lauravmorenoc/Praxis_Laura/Pictures/1.jpg

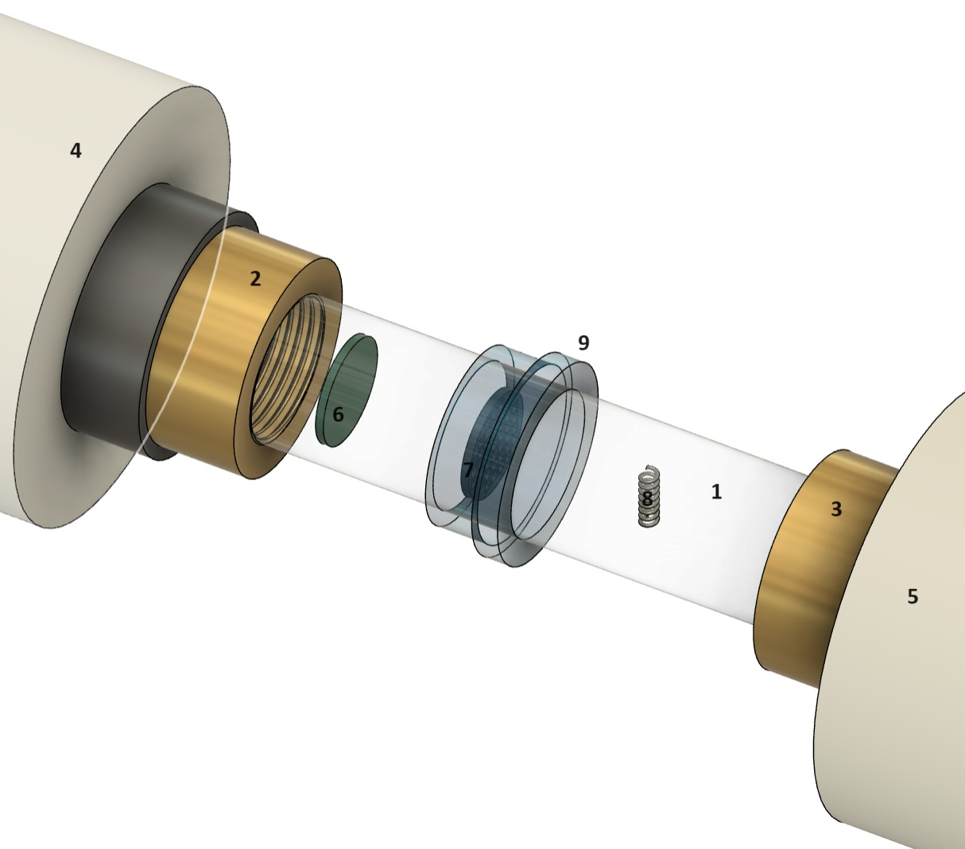
Pictures/1.jpg
