lauravmorenoc/Praxis_Laura/README.md

# Praxis_Laura

### Decided on 19.12.2023:
Die Idee, die die vier Stäbchen hat, können wir versuchen. Aber statt der Löchen in den Ringen kann man was, das die Ringen stützt (wie Schraube), benutzen.
