lauravmorenoc/Praxis_Laura/Pictures/2.jpg

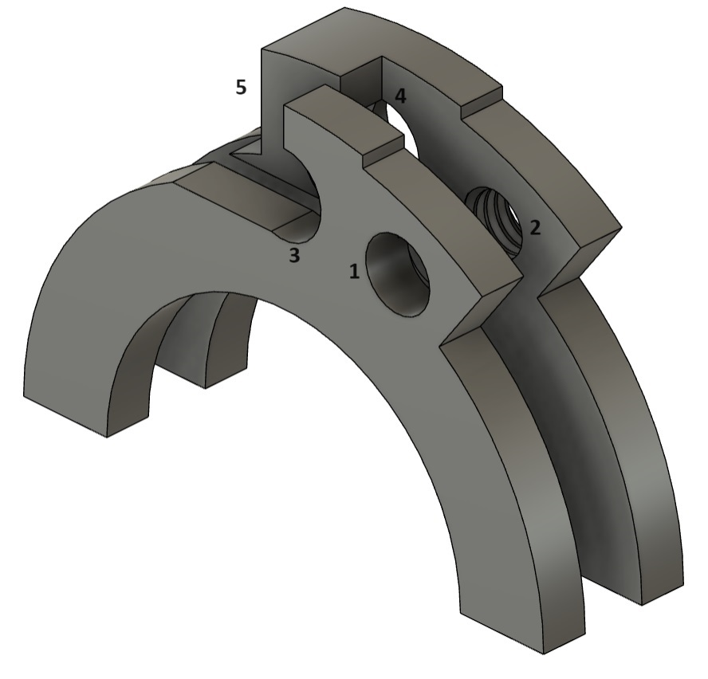
Pictures/2.jpg
