lauravmorenoc/Praxis_Laura/Pictures/2_1.jpg

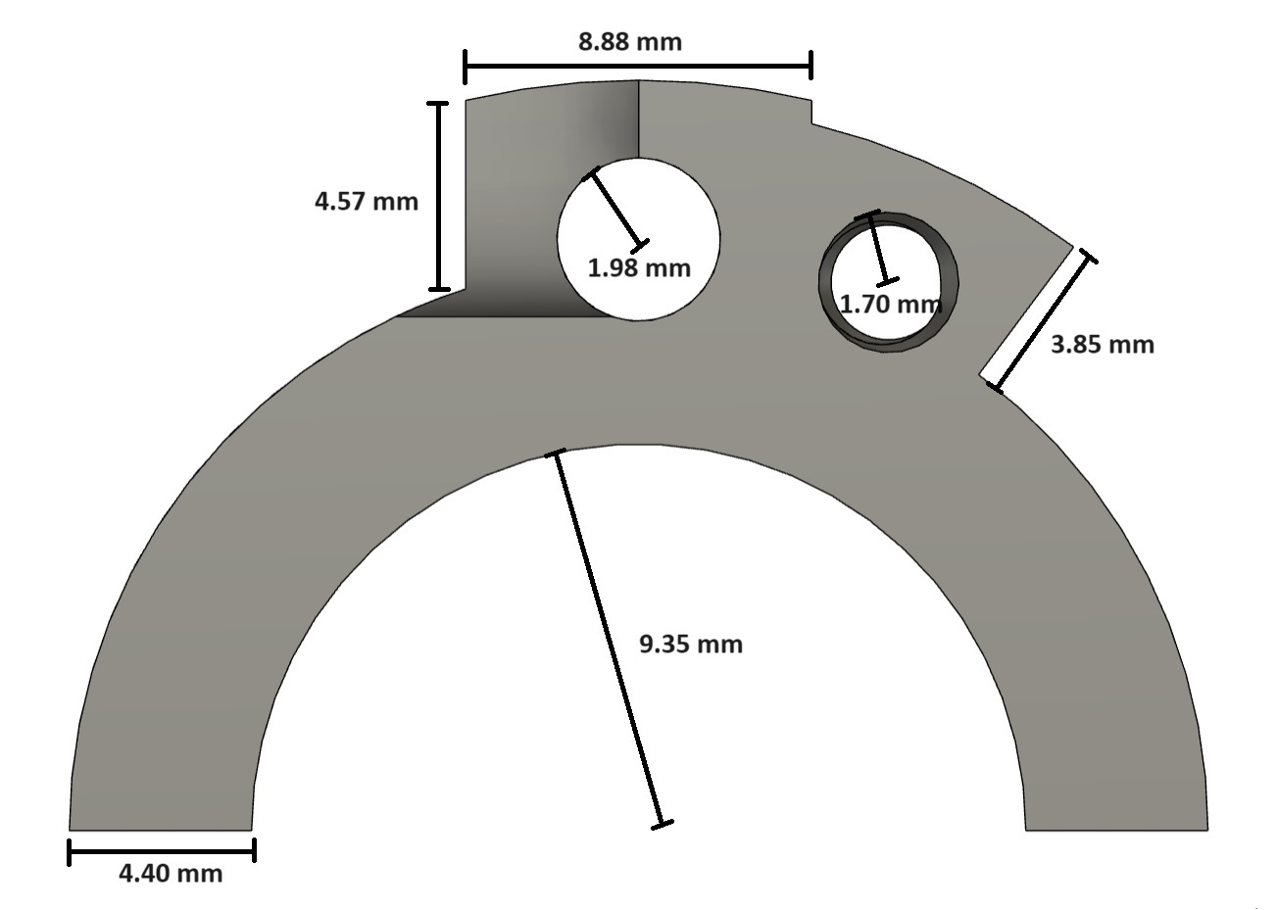
Pictures/2_1.jpg
