lauravmorenoc/Praxis_Laura/Pictures/2_2.jpg

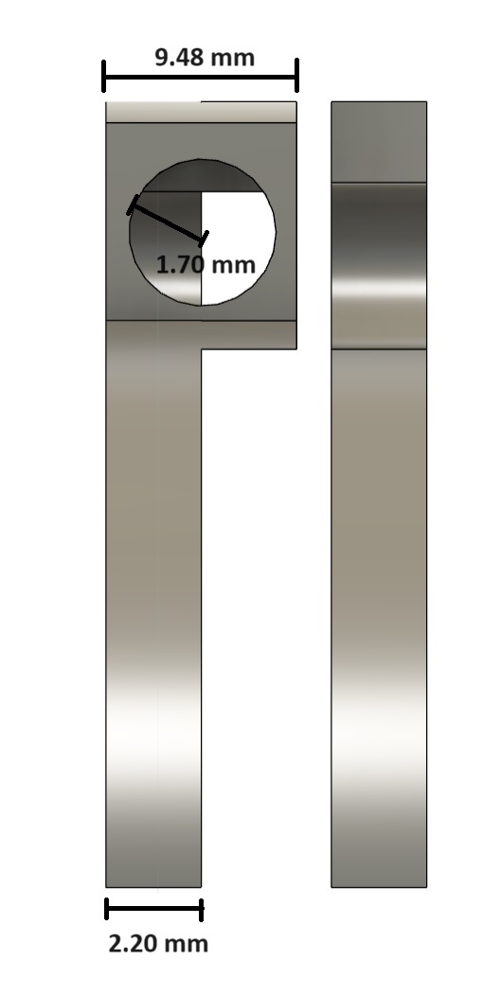
Pictures/2_2.jpg
