lauravmorenoc/Praxis_Laura/Pictures/3.jpg

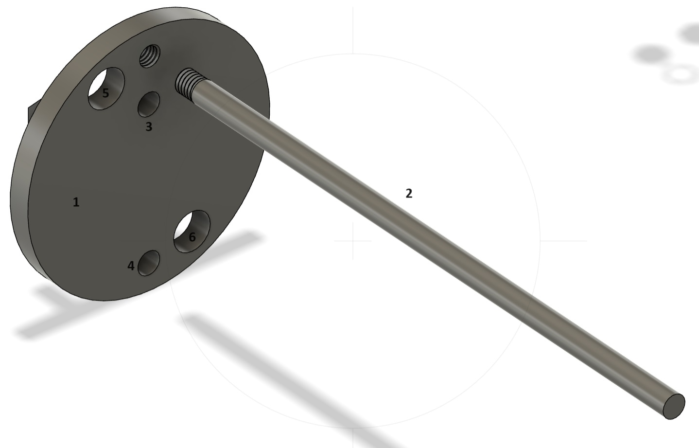
Pictures/3.jpg
