lauravmorenoc/Praxis_Laura/Pictures/3_1.jpg

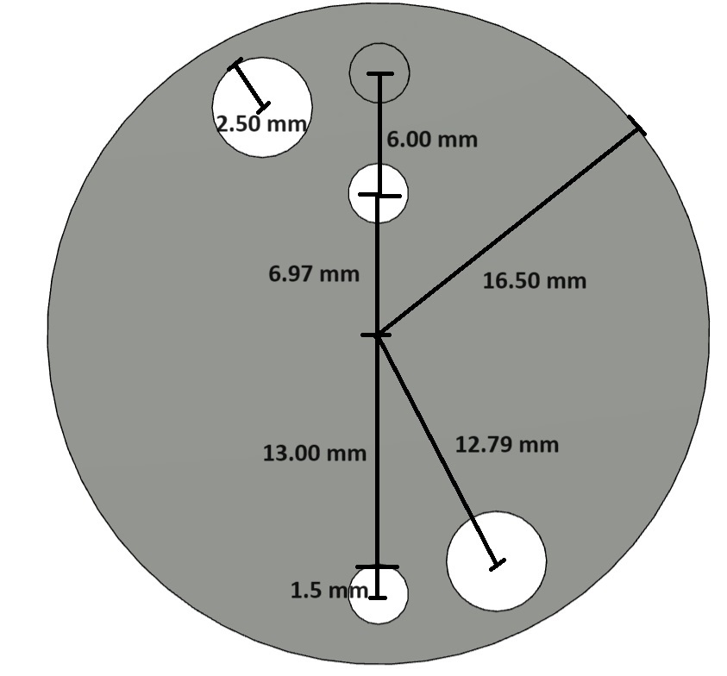
Pictures/3_1.jpg
