lauravmorenoc/Praxis_Laura/Pictures/3_2.jpg

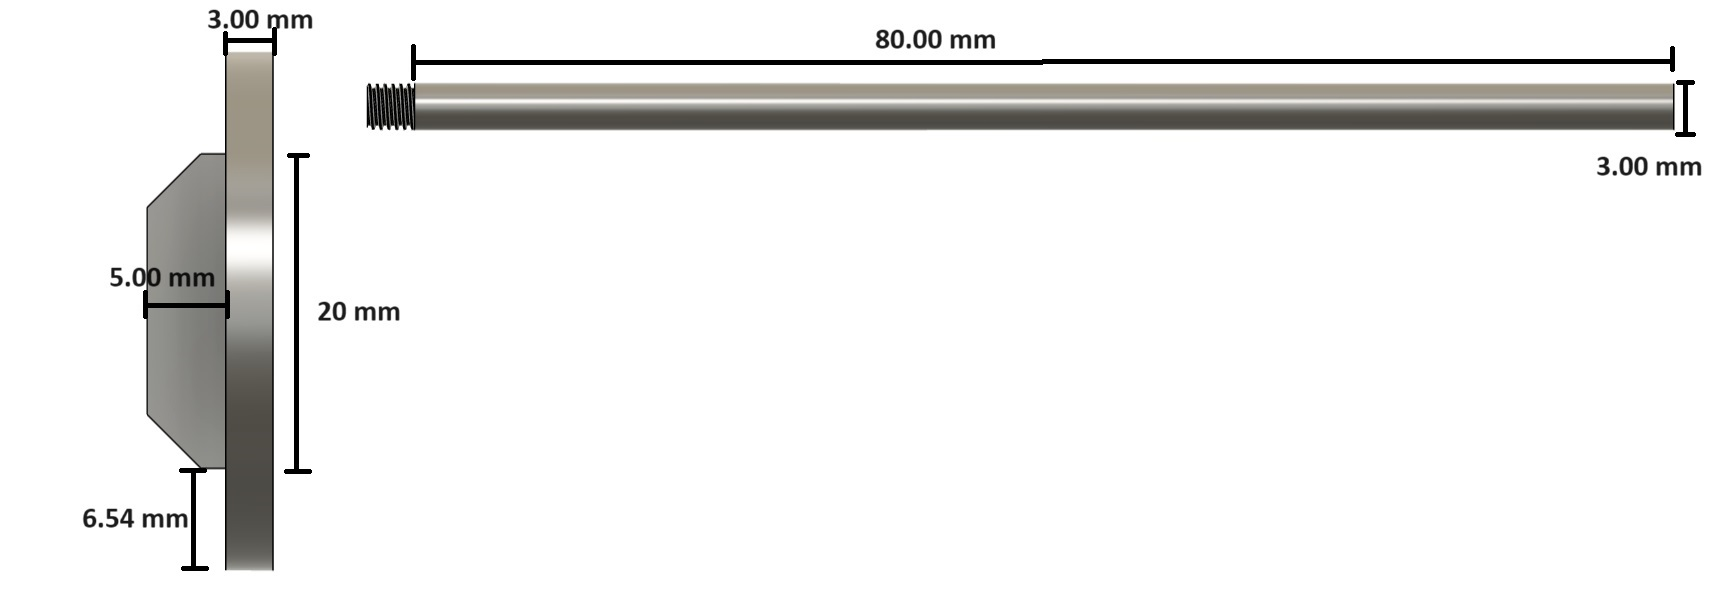
Pictures/3_2.jpg
