lauravmorenoc/Praxis_Laura/Pictures/4.jpg

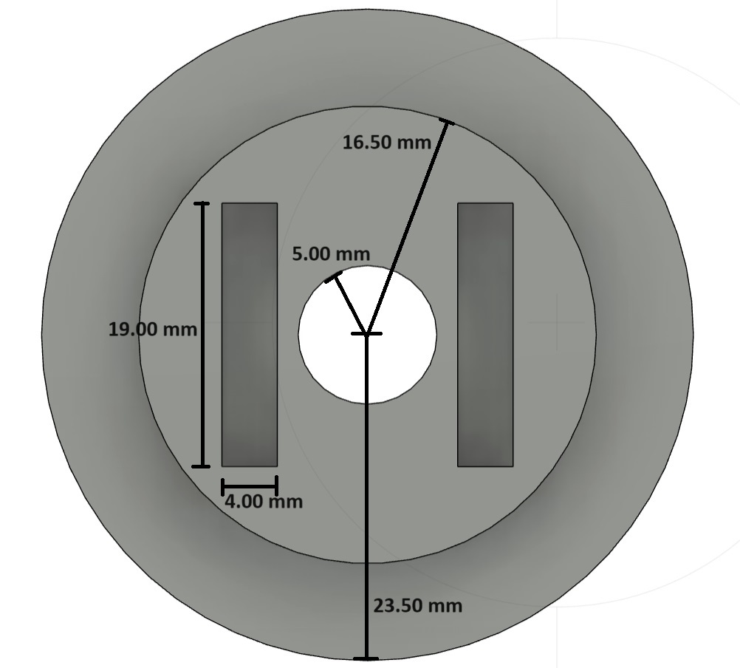
Pictures/4.jpg
