lauravmorenoc/Praxis_Laura/Pictures/4_1.jpg

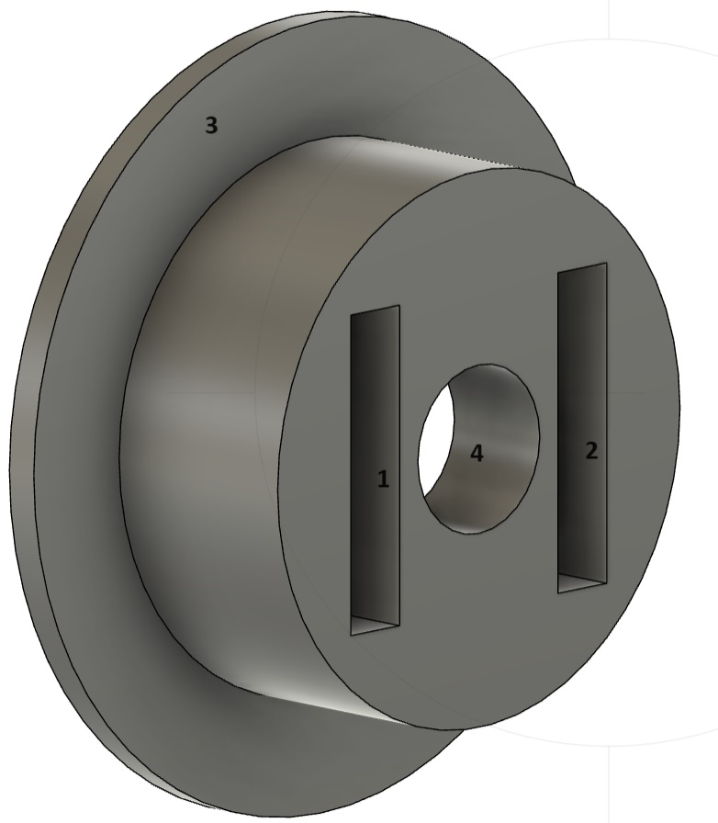
Pictures/4_1.jpg
