lauravmorenoc/Praxis_Laura/Pictures/5.jpg

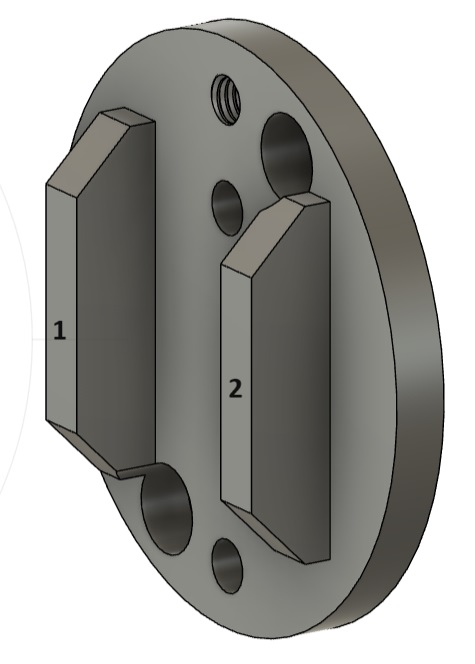
Pictures/5.jpg
