lauravmorenoc/Praxis_Laura/Pictures/6.jpg

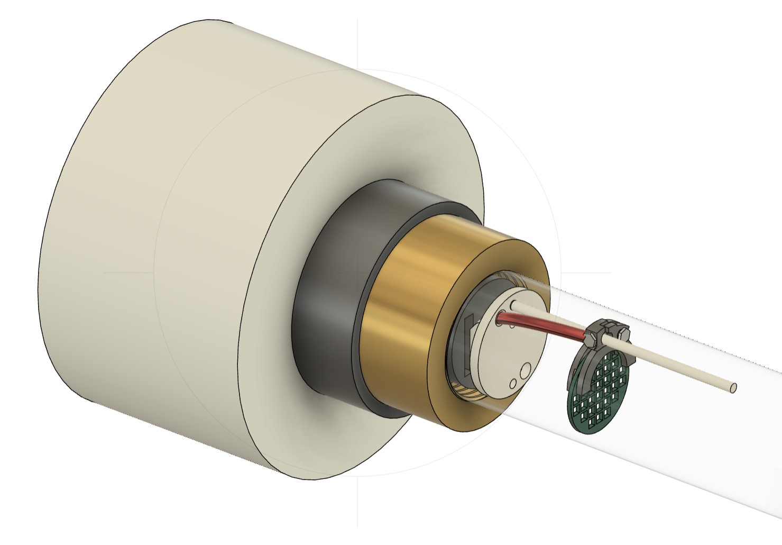
Pictures/6.jpg
