lauravmorenoc/Praxis_Laura/Pictures/Circuit.jpeg

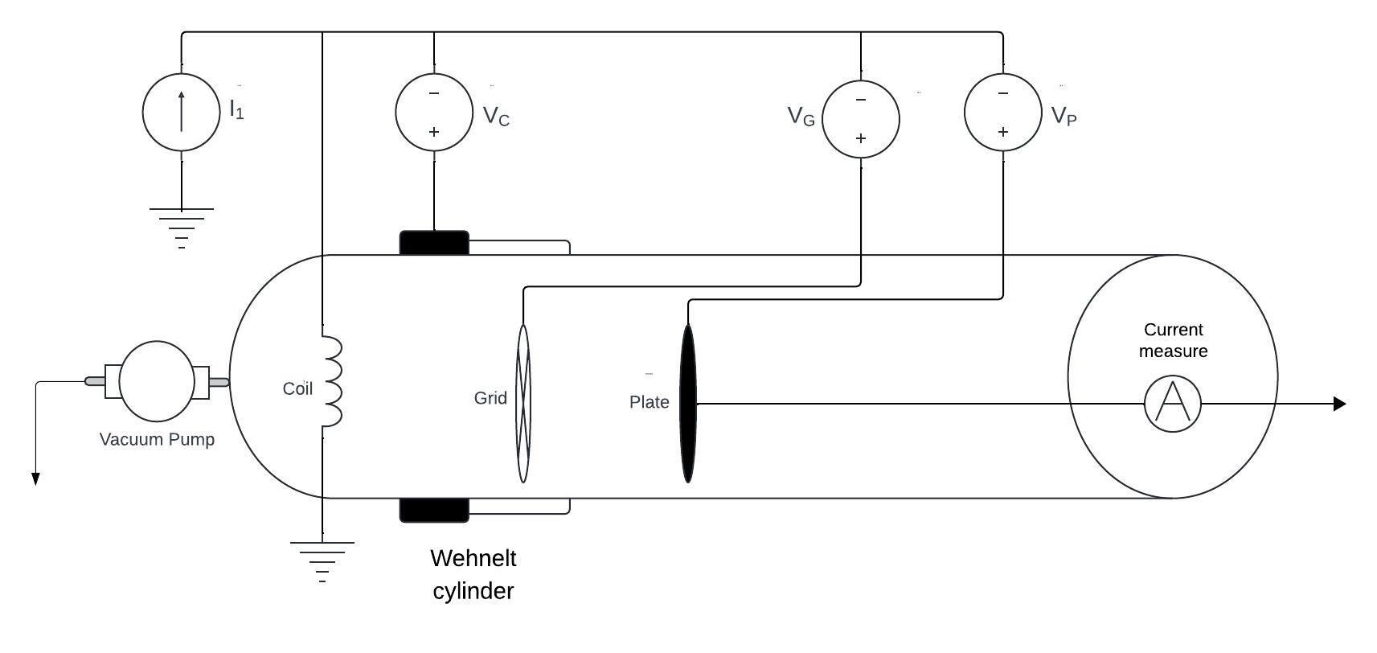
Pictures/Circuit.jpeg
