lauravmorenoc/Praxis_Laura/Pictures/Circuit_upd.jpeg

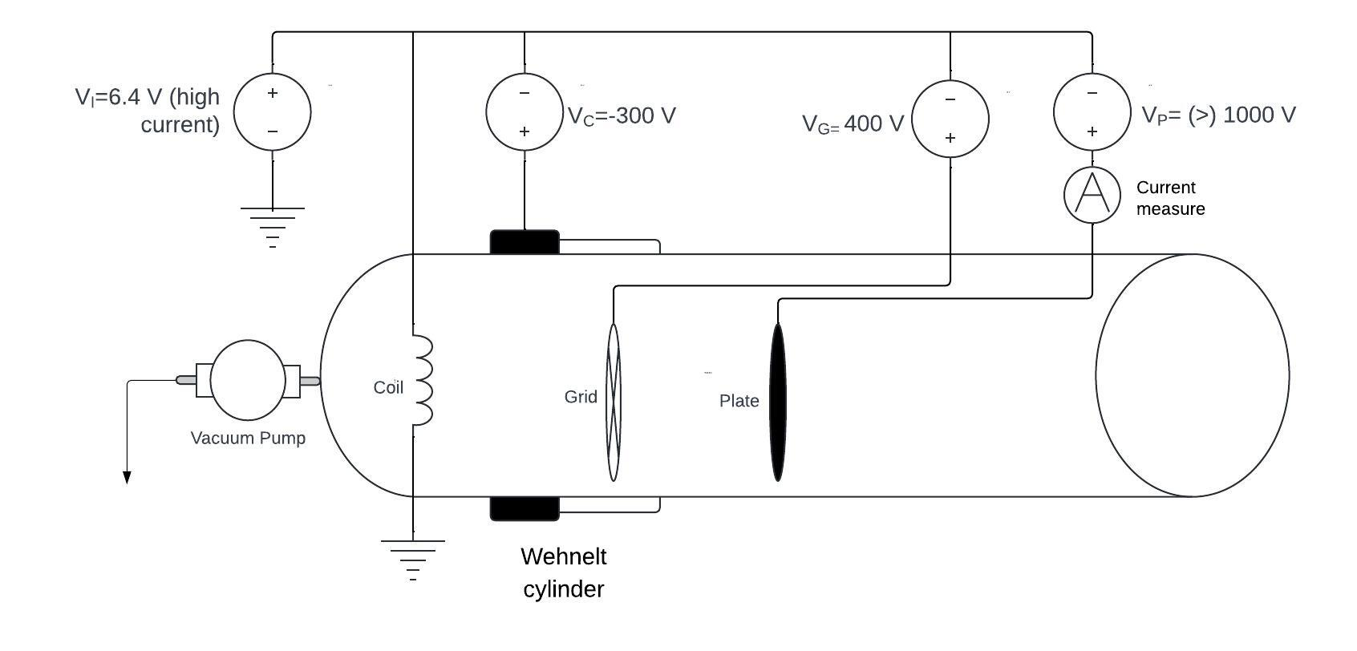
Pictures/Circuit_upd.jpeg
