lauravmorenoc/Praxis_Laura/Pictures/cylinder.jpg

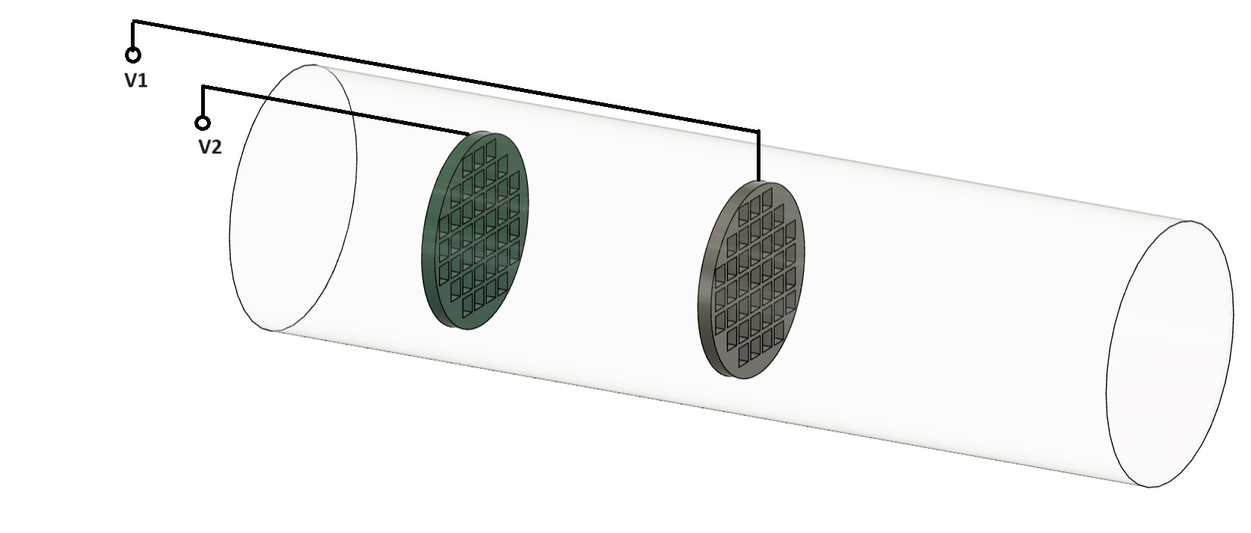
Pictures/cylinder.jpg
