lauravmorenoc/Praxis_Laura/Pictures/op.png

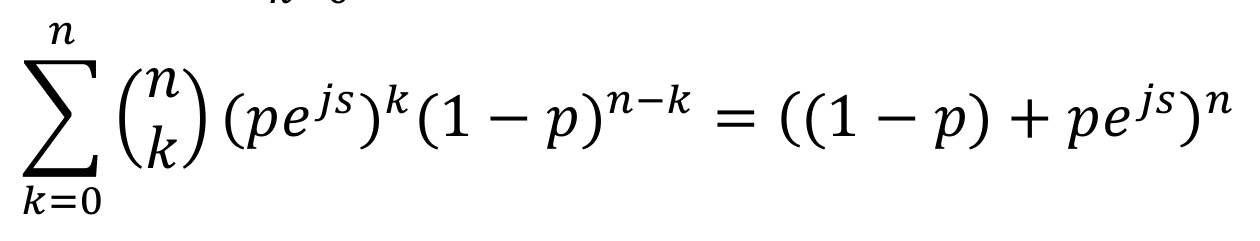
Pictures/op.png
