lauravmorenoc/Praxis_Laura/Pictures/Paschen.png

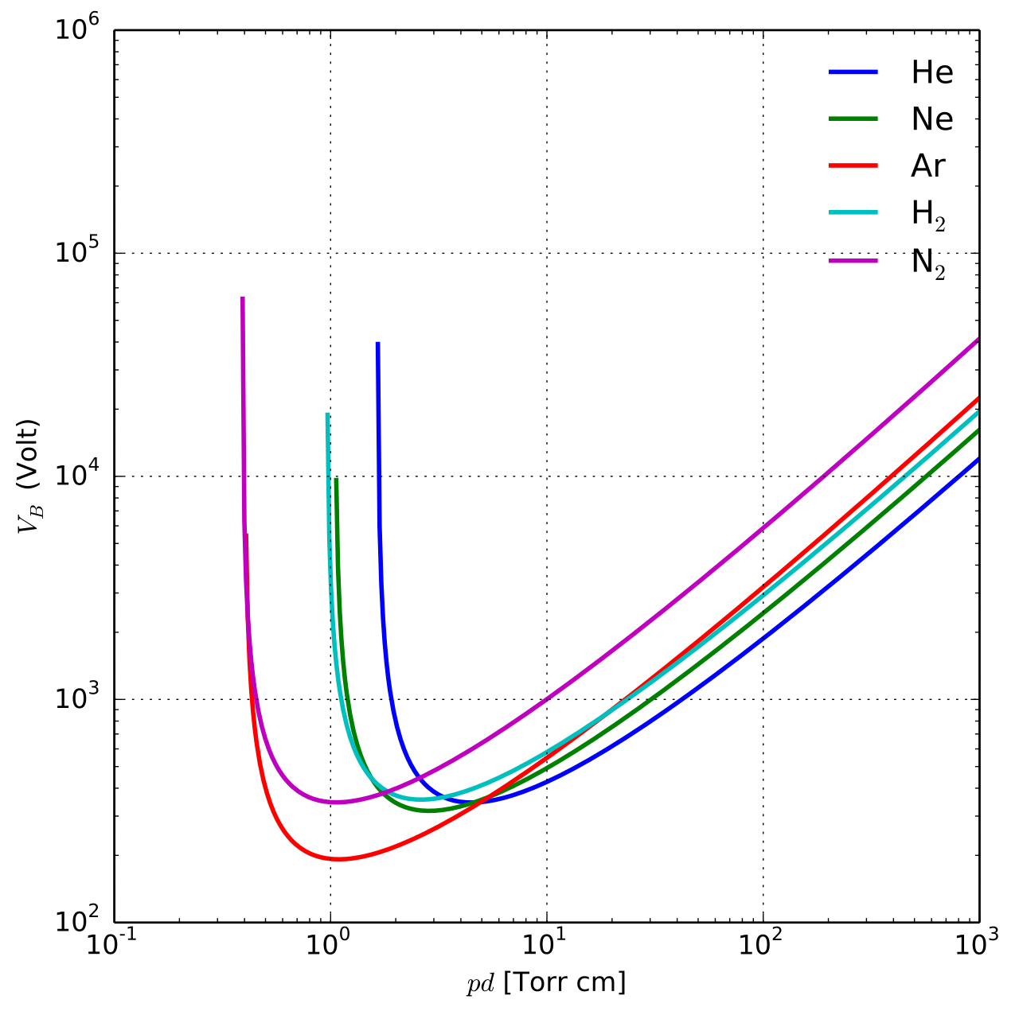
Pictures/Paschen.png
