lauravmorenoc/Praxis_Laura/Pictures/voltages.png

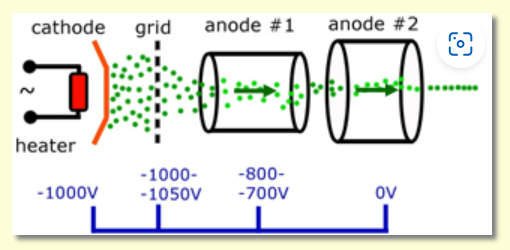
Pictures/voltages.png
