lauravmorenoc/Praxis_Laura/Beispiel.3mf

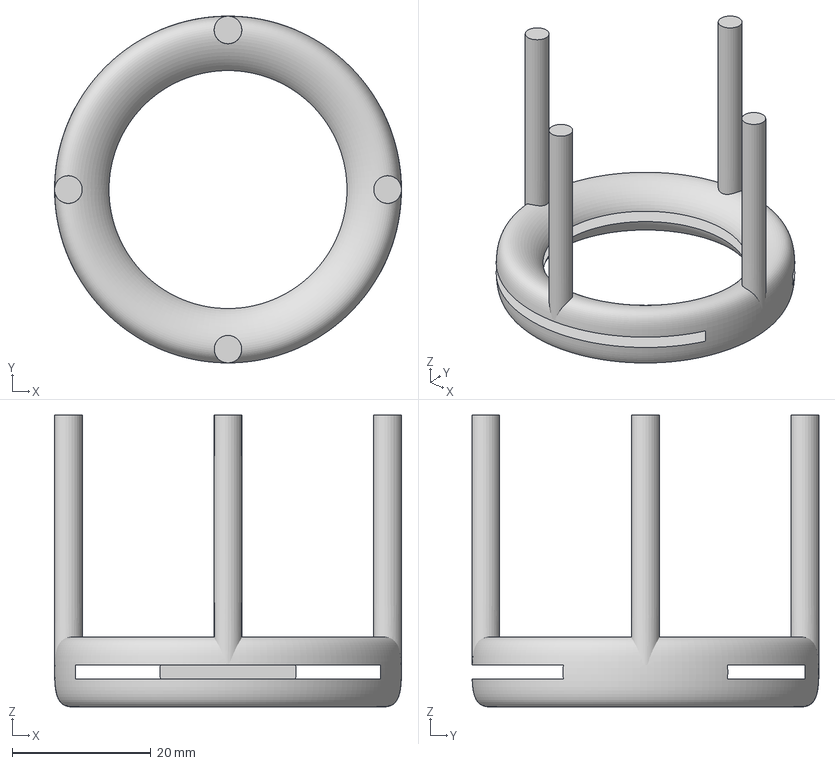
[picture p18: CAD file, 2023-12-19]
Beispiel.3mf
50.0 x 50.0 x 42.0 mm
