lauravmorenoc/Praxis_Laura/Design/Flaeche.dxf

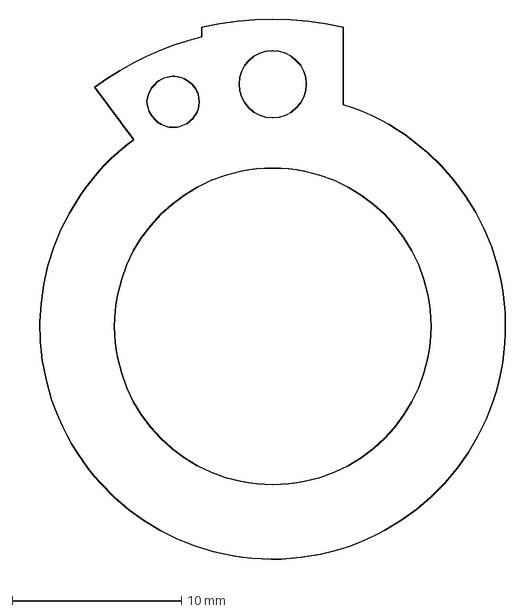
[picture p19: CAD file, 2024-06-17]
Design/Flaeche.dxf
29.3 x 32.9 mm
