lauravmorenoc/Praxis_Laura/Design/Körper13.stl

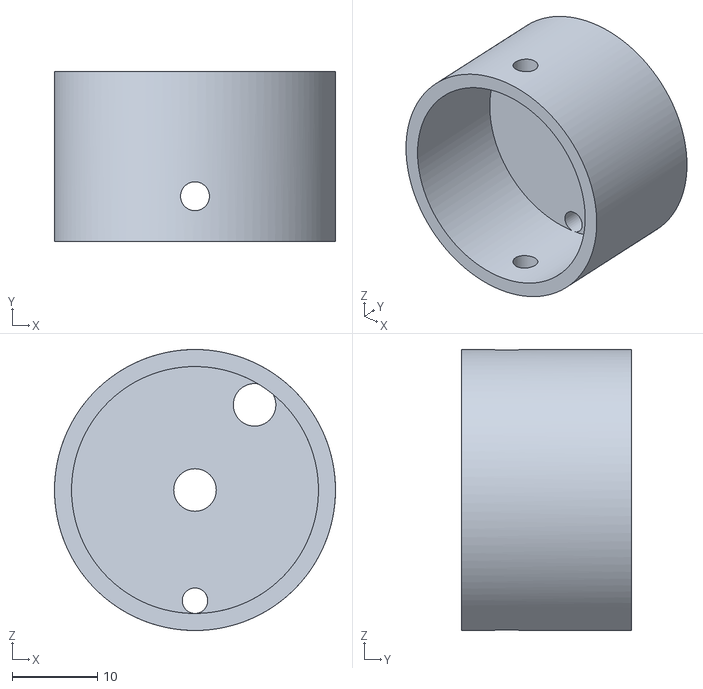
[picture p20: CAD file, 2024-06-17]
Design/Körper13.stl
33.0 x 20.0 x 33.0
