lauravmorenoc/Praxis_Laura/Design/Gewinde_klein.stl

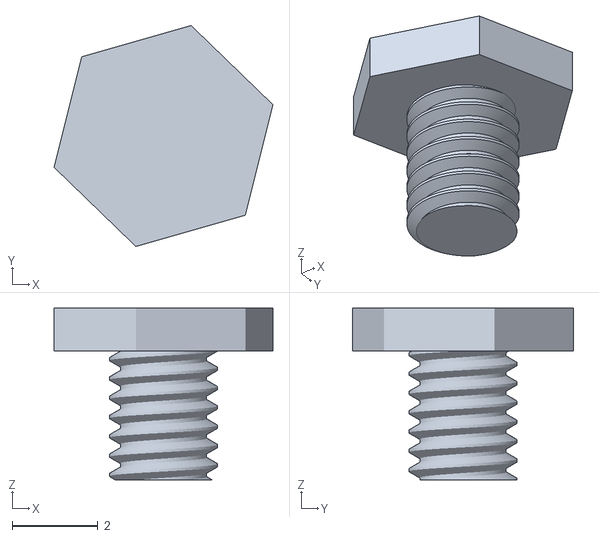
[picture p21: CAD file, 2024-06-17]
Design/Gewinde_klein.stl
5.11 x 5.15 x 4.00
