lauravmorenoc/Praxis_Laura/Design/Körper12.stl

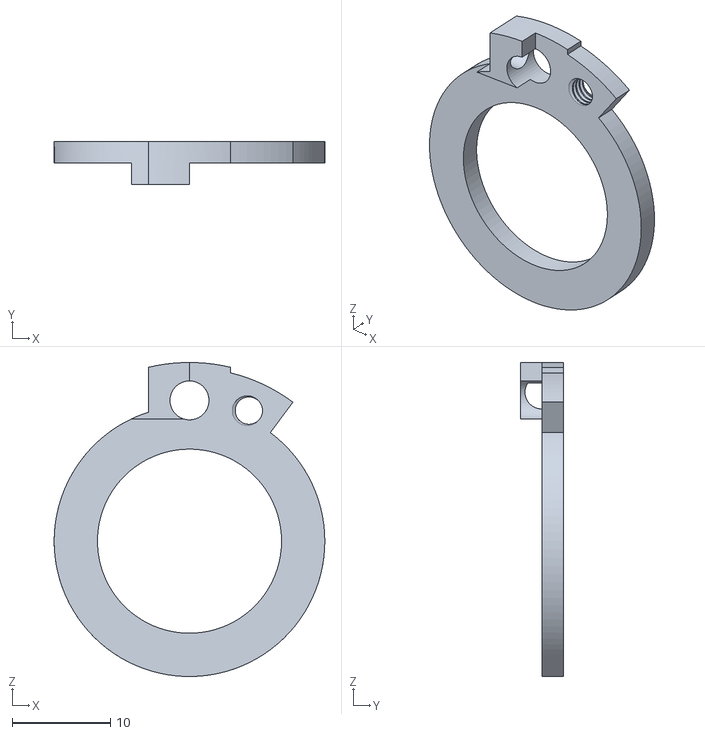
[picture p22: CAD file, 2024-06-17]
Design/Körper12.stl
27.5 x 4.40 x 31.9
