lauravmorenoc/Praxis_Laura/Design/Platte v3.dxf

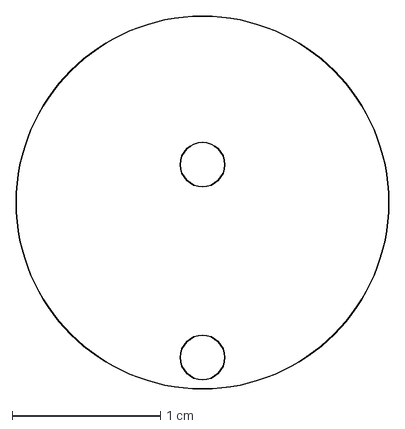
[picture p23: CAD file, 2024-06-17]
Design/Platte v3.dxf
2.51 x 2.51 cm
