lauravmorenoc/Praxis_Laura/Design/Körper25.stl

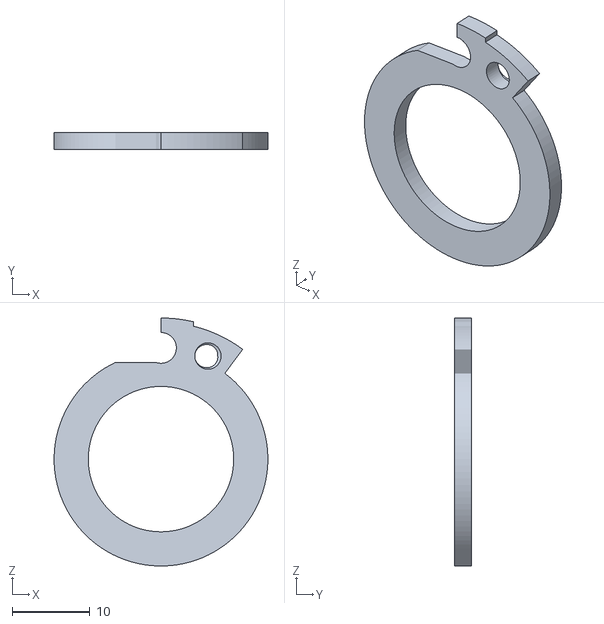
[picture p24: CAD file, 2024-06-17]
Design/Körper25.stl
27.5 x 2.20 x 31.9
