lauravmorenoc/Praxis_Laura/Design/Körper27.stl

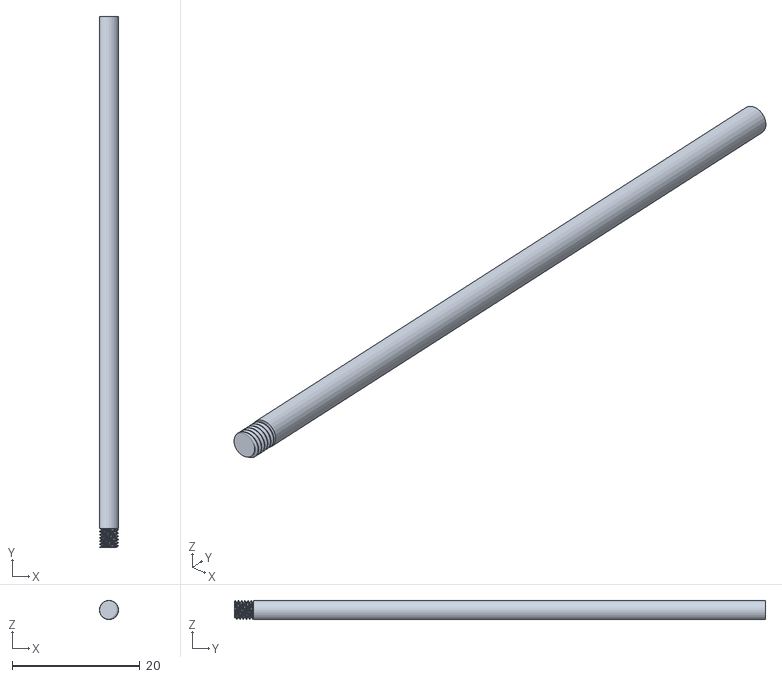
[picture p25: CAD file, 2024-04-08]
Design/Körper27.stl
3.00 x 83.0 x 3.00
