lauravmorenoc/Praxis_Laura/(list of files, cad)

Other CAD files:
Design/Platte2.dxf
Design.f3d
Rub_1 v1.f3d
