lauravmorenoc/Praxis_Laura/(commit log)

2023-12-19 A few files to start
    [Cuerpo1.3mf, Rub_1 v1.f3d]
2024-03-26 Design fertig gemacht
    [Beispiel.3mf, Design.f3d, Körper1.stl, Körper10.stl, Körper11.stl, Körper12.stl, Körper13.stl, Körper2.stl]
2024-03-26 Einige Änderungen gemacht
    [Körper12.stl, Körper17.stl, Körper2.stl]
2024-04-08 Final design
    [Körper1.stl, Körper10.stl, Körper11.stl, Körper12.stl, Körper13.stl, Körper17.stl, Körper24.stl, Körper25.stl]
